york-fs/bms-master/bms_master.kicad_pcb

## KiCad design bms_master.kicad_pcb (2025-06-18)

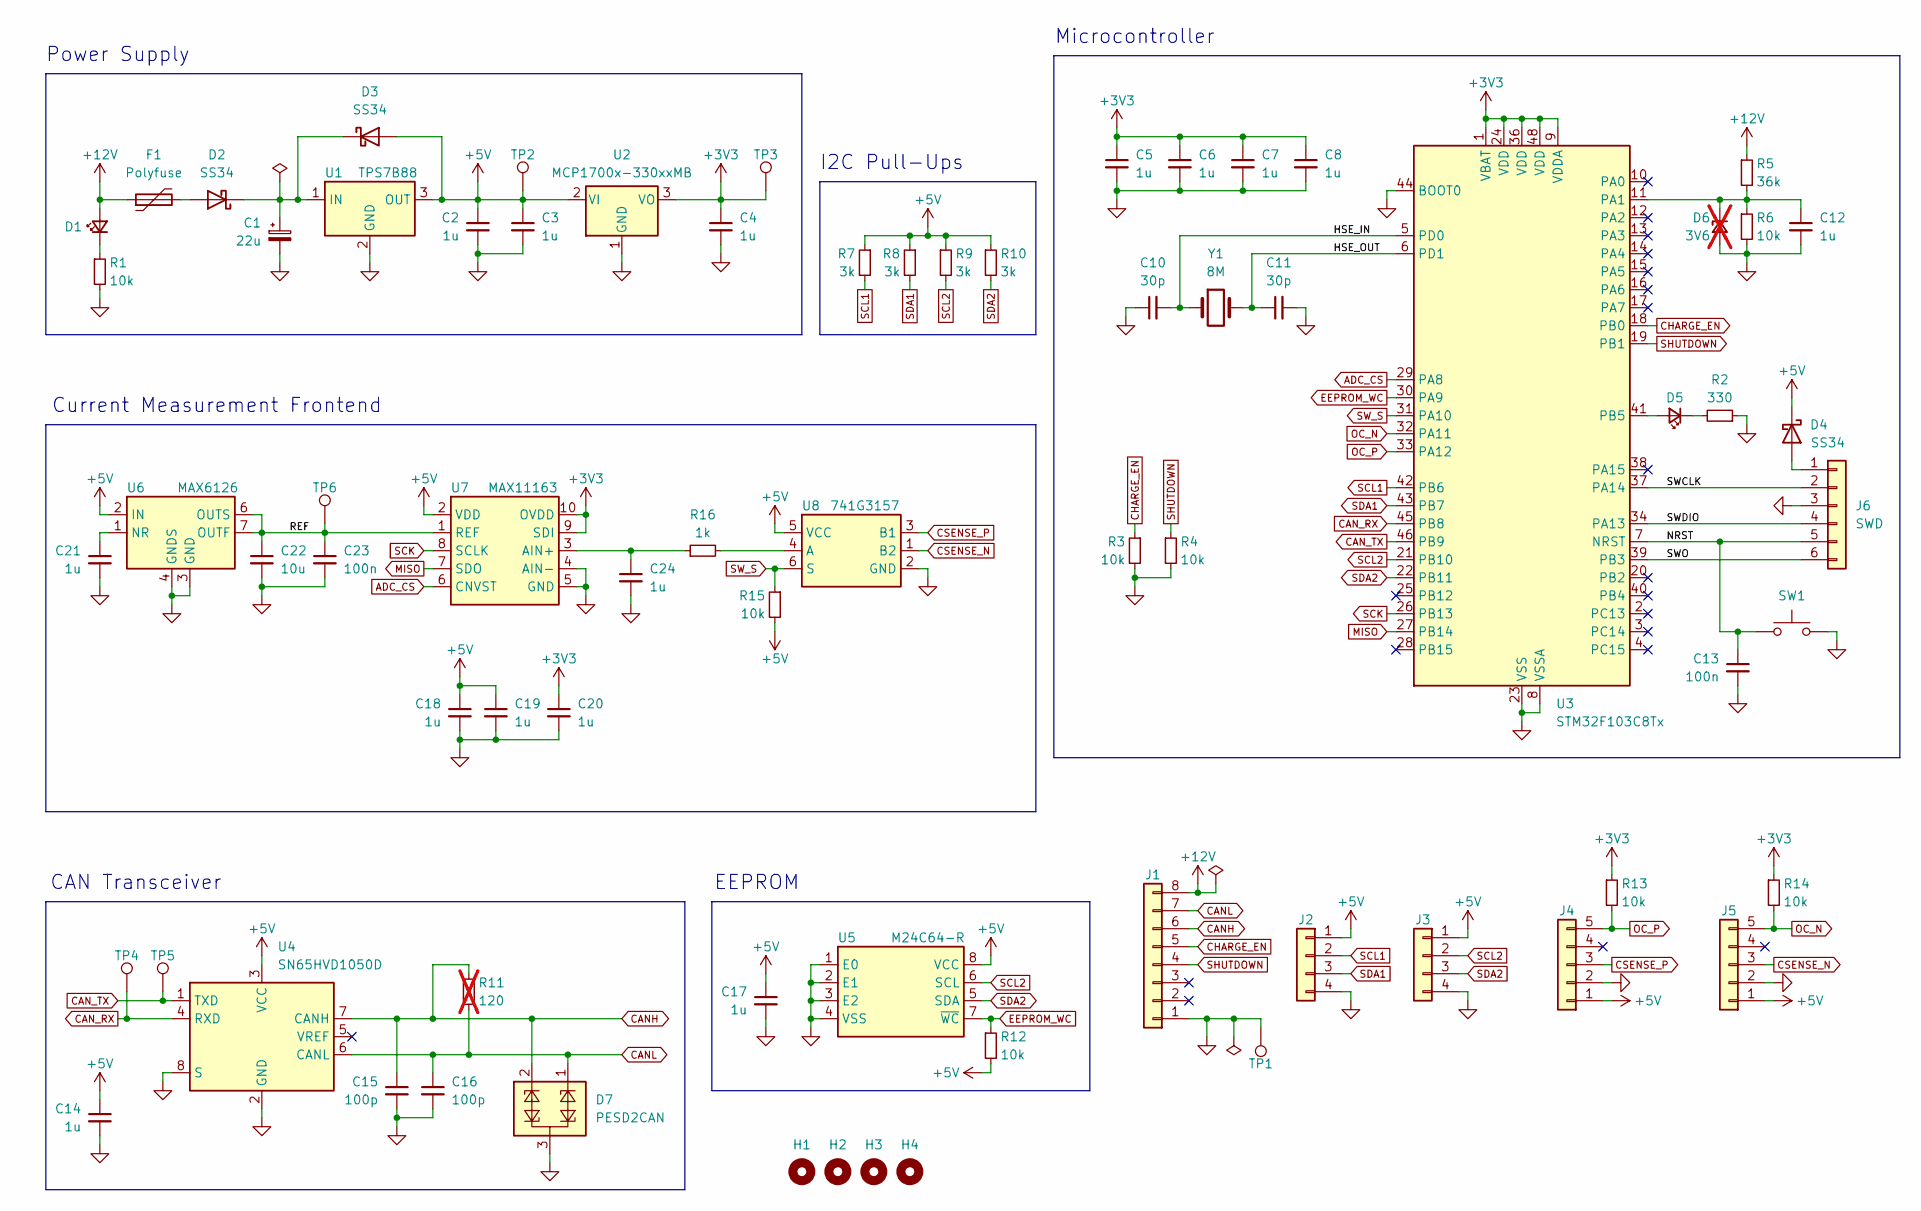
[picture p1: schematic bms_master.kicad_sch, Battery Management System Master]

Parts:
C1: 22u; CP_Elec_6.3x7.7; Mfr # EEEFK1J220XP
C2, C3, C4, C5, C6, C7, C8, C12, C14, C17, C18, C19, C20, C21, C24: 1u; C_0603_1608Metric; Mfr # CL10B105KB8NQNC
C10, C11: 30p; C_0603_1608Metric; Mfr # GQM1875C2E300GB12D
C13, C23: 100n; C_0603_1608Metric; Mfr # CL10B104KB8NNNC
C15, C16: 100p; C_0603_1608Metric
C22: 10u; C_1206_3216Metric; Mfr # GRM31CR71C106KA12L
D1, D5: LED_Small; LED_0603_1608Metric; Mfr # NCD0603R1
D2, D3, D4: SS34; D_SMA; Mfr # SS34-MS
D6: 3V6; D_SOD-323; not fitted
D7: PESD2CAN; SOT-23; Mfr # PESD2CAN,215
F1: Polyfuse; C_0805_2012Metric; Mfr # 0805L010/24YR
H1, H2, H3, H4: MountingHole; MountingHole_3.2mm_M3
J1: Conn_01x08; Molex_Micro-Fit_3.0_43045-0812_2x04_P3.00mm_Vertical
J2, J3: I2C; JST_PH_S4B-PH-K_1x04_P2.00mm_Horizontal; Mfr # S4B-PH-K-S(LF)(SN)
J4, J5: CSENSE; JST_PH_S5B-PH-K_1x05_P2.00mm_Horizontal; Mfr # S5B-PH-K-S(LF)(SN)
J6: SWD; PinHeader_1x06_P2.54mm_Vertical; Mfr # HB-PH3-25417PB2GOP
R1, R3, R4, R6, R12, R13, R14, R15: 10k; R_0603_1608Metric; Mfr # 0603WAF1002T5E
R2: 330; R_0603_1608Metric; Mfr # 0603WAF3300T5E
R5: 36k; R_0603_1608Metric
R7, R8, R9, R10: 3k; R_0603_1608Metric; Mfr # 0603WAF3001T5E
R11: 120; R_0603_1608Metric; not fitted
R16: 1k; R_0603_1608Metric; Mfr # 0603WAF1001T5E
SW1: SW_Push; SW_Push_SPST_NO_Alps_SKRK; Mfr # TS-1088-AR02016
TP1, TP2, TP3, TP4, TP5, TP6: TestPoint; TestPoint_Keystone_5000-5004_Miniature
U1: TPS7B88; TO-252-2; Mfr # 595-TPS7B8850QKVURQ1
U2: MCP1700x-330xxMB; SOT-89-3; Mfr # MCP1700T-3302E/MB
U3: STM32F103C8Tx; LQFP-48_7x7mm_P0.5mm; Mfr # STM32F103C8T6
U4: SN65HVD1050D; SOIC-8_3.9x4.9mm_P1.27mm; Mfr # SN65HVD1050DR
U5: M24C64-R; SOIC-8_3.9x4.9mm_P1.27mm; Mfr # M24C64-RMN6TP
U6: MAX6126; SOIC-8_3.9x4.9mm_P1.27mm; Mfr # MAX6126BASA41+
U7: MAX11163; MSOP-10_3x3mm_P0.5mm; Mfr # MAX11163EUB+
U8: 741G3157; SOT-363_SC-70-6; Mfr # SN74LVC1G3157DCKR
Y1: 8M; Crystal_SMD_5032-2Pin_5.0x3.2mm; Mfr # X50328MSB2GI

Connections:
+3V3: C4.1, C5.1, C6.1, C7.1, C8.1, C20.1, R13.1, R14.1, TP3.1, U2.3 (VO), U3.1 (VBAT), U3.9 (VDDA), U3.24 (VDD), U3.36 (VDD), U3.48 (VDD), U7.9 (SDI), U7.10 (OVDD)
+5V: C2.1, C3.1, C14.1, C17.1, C18.1, C19.1, D3.2 (A), D4.1 (K), J2.1, J3.1, J4.1, J5.1, R7.1, R8.1, R9.1, R10.1, R12.2, R15.2, TP2.1, U1.3 (OUT), U2.2 (VI), U4.3 (VCC), U5.8 (VCC), U6.2 (IN), U7.2 (VDD), U8.5 (VCC)
+12V: D1.2 (A), F1.1, J1.8, R5.1
/HSE_IN: C10.2, U3.5 (PD0), Y1.1
/HSE_OUT: C11.1, U3.6 (PD1), Y1.2
/NRST: C13.1, J6.5, SW1.1, U3.7 (NRST)
/REF: C22.1, C23.1, TP6.1, U6.6 (OUTS), U6.7 (OUTF), U7.1 (REF)
/SWCLK: J6.2, U3.37 (PA14)
/SWDIO: J6.4, U3.34 (PA13)
/SWO: J6.6, U3.39 (PB3)
ADC_CS: U3.29 (PA8), U7.6 (CNVST)
CANH: C15.1, D7.2 (C2), J1.6, R11.1, U4.7 (CANH)
CANL: C16.1, D7.1 (C1), J1.7, R11.2, U4.6 (CANL)
CAN_RX: TP4.1, U3.45 (PB8), U4.4 (RXD)
CAN_TX: TP5.1, U3.46 (PB9), U4.1 (TXD)
CHARGE_EN: J1.5, R3.1, U3.18 (PB0)
CSENSE_N: J5.3, U8.1 (B2)
CSENSE_P: J4.3, U8.3 (B1)
EEPROM_WC: R12.1, U3.30 (PA9), U5.7 (~WC)
GND: C1.2, C2.2, C3.2, C4.2, C5.2, C6.2, C7.2, C8.2, C10.1, C11.2, C12.2, C13.2, C14.2, C15.2, C16.2, C17.2, C18.2, C19.2, C20.2, C21.2, C22.2, C23.2, C24.2, D6.2 (A), D7.3 (CC), J1.1, J2.4, J3.4, J4.2, J5.2, J6.3, R1.2, R2.1, R3.2, R4.2, R6.2, SW1.2, TP1.1, U1.2 (GND), U2.1 (GND), U3.8 (VSSA), U3.23 (VSS), U3.35 (VSS), U3.44 (BOOT0), U3.47 (VSS), U4.2 (GND), U4.8 (S), U5.1 (E0), U5.2 (E1), U5.3 (E2), U5.4 (VSS), U6.3 (GND), U6.4 (GNDS), U7.4 (AIN-), U7.5 (GND), U8.2 (GND)
MISO: U3.27 (PB14), U7.7 (SDO)
unnamed: D1.1 (K), R1.1
unnamed: D2.2 (A), F1.2
unnamed: C1.1, D2.1 (K), D3.1 (K), U1.1 (IN)
unnamed: D4.2 (A), J6.1
unnamed: D5.2 (A), U3.41 (PB5)
unnamed: D5.1 (K), R2.2
unnamed: C12.1, D6.1 (K), R5.2, R6.1, U3.11 (PA1)
unnamed: C21.1, U6.1 (NR)
unnamed: C24.1, R16.1, U7.3 (AIN+)
unnamed: R16.2, U8.4 (A)
OC_N: J5.5, R14.2, U3.32 (PA11)
OC_P: J4.5, R13.2, U3.33 (PA12)
SCK: U3.26 (PB13), U7.8 (SCLK)
SCL1: J2.2, R7.2, U3.42 (PB6)
SCL2: J3.2, R9.2, U3.21 (PB10), U5.6 (SCL)
SDA1: J2.3, R8.2, U3.43 (PB7)
SDA2: J3.3, R10.2, U3.22 (PB11), U5.5 (SDA)
SHUTDOWN: J1.4, R4.1, U3.19 (PB1)
SW_S: R15.1, U3.31 (PA10), U8.6 (S)

Notes on the sheet:
Power Supply
I2C Pull-Ups
Microcontroller
EEPROM
CAN Transceiver
Current Measurement Frontend

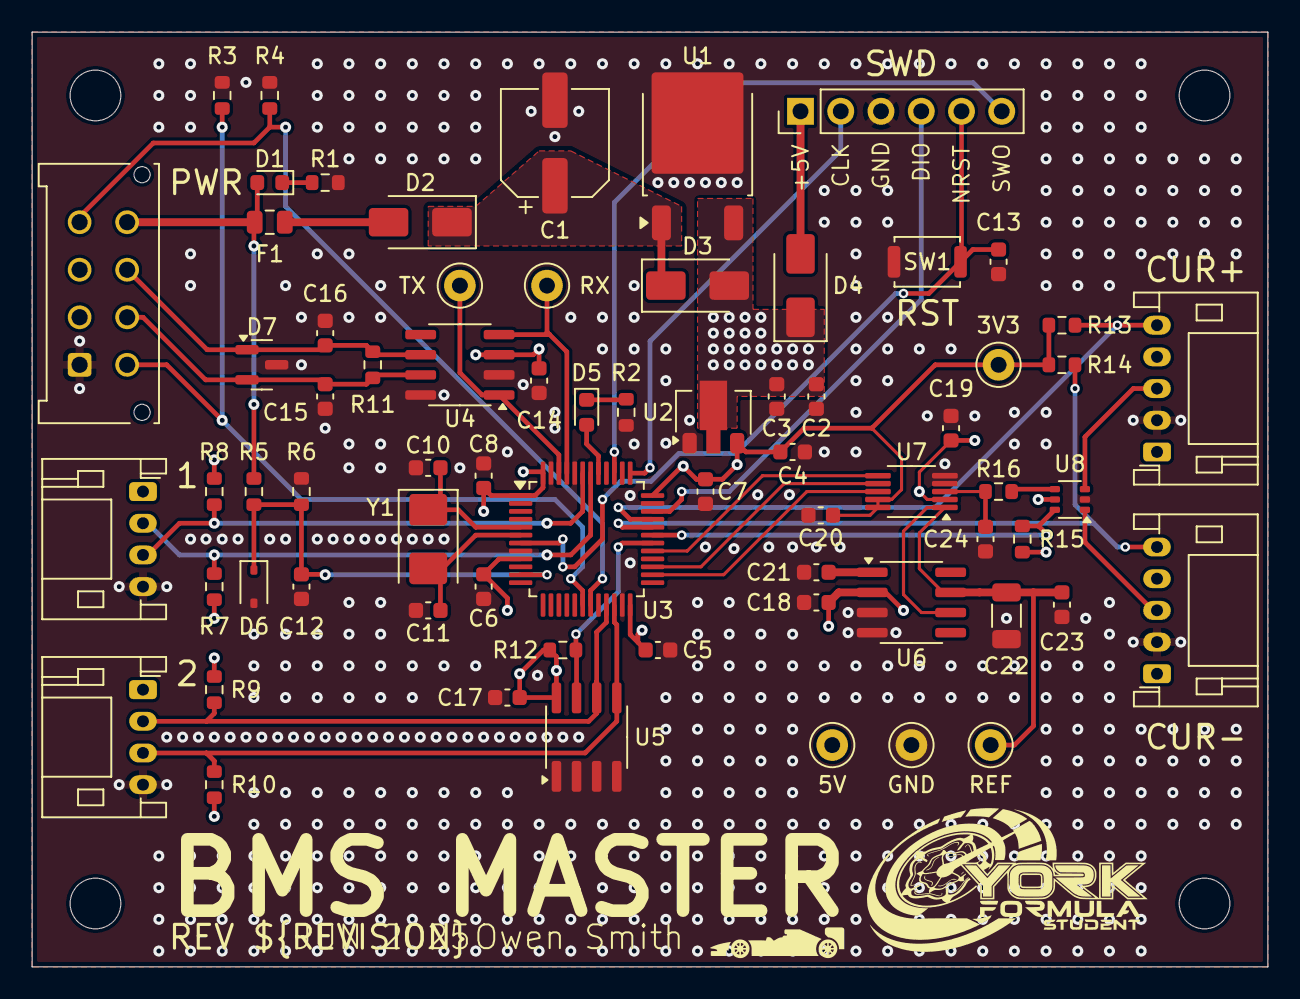
[picture p2: board bms_master.kicad_pcb from above]

Board: 4 copper layers, 78.0 x 59.0 mm, 73 parts (0 on the bottom side), 40 nets.
