york-fs/bms-master/(commit log)

2025-04-27 schematic: Add shutdown and charge enable outputs
    [bms_master.kicad_sch]
2025-04-27 schematic: Measure 12V rail with STM ADC
    [bms_master.kicad_sch]
2025-04-27 schematic: Re-annotate designators
    [bms_master.kicad_sch]
2025-04-27 schematic: Fix overcurrent pin pull-up voltage
    [bms_master.kicad_sch]
2025-04-27 schematic: Assign some net classes
2025-05-04 schematic: Assign most footprints
    [bms_master.kicad_sch]
2025-05-04 schematic: Fill in most BOM info
    [bms_master.kicad_sch]
2025-05-04 schematic: Allow powering 5V rail from SWD header
    [bms_master.kicad_sch]
2025-05-04 schematic: Choose a footprint for the main connector
    [bms_master.kicad_sch]
2025-05-04 pcb: Setup PCB settings
    [bms_master.kicad_pcb]
2025-05-04 *: Add initial PCB layout
    [bms_master.kicad_pcb, bms_master.kicad_sch]
2025-05-04 pcb: Move connectors slightly towards board edge
    [bms_master.kicad_pcb]
2025-05-04 pcb: Add some more silkscreen
    [bms_master.kicad_pcb]
2025-05-05 pcb: Improve silkscreen and add a few more GND vias
    [bms_master.kicad_pcb]
2025-05-05 *: Bump issue date
    [bms_master.kicad_pcb, bms_master.kicad_sch]
2025-05-05 pcb: Run cleanup graphics
    [bms_master.kicad_pcb]
2025-05-05 pcb: Run cleanup tracks
    [bms_master.kicad_pcb]
2025-05-05 pcb: Move OC_N track slightly
    [bms_master.kicad_pcb]
2025-05-11 pcb: Add some more GND vias
    [bms_master.kicad_pcb]
2025-05-11 pcb: Add GND between SPI lines
    [bms_master.kicad_pcb]
2025-05-11 pcb: Set gerber output parameters
    [bms_master.kicad_pcb]
2025-06-04 *: Update library references and move SWD header slightly
    [bms_master.kicad_pcb, bms_master.kicad_sch]
2025-06-07 *: Change all 100k pull-up and pull-downs to 10k
    [bms_master.kicad_pcb, bms_master.kicad_sch]
2025-06-07 pcb: Remove unnecessary 5V via for test point
    [bms_master.kicad_pcb]
2025-06-07 *: Add a test point for the reference
    [bms_master.kicad_pcb, bms_master.kicad_sch]
2025-06-18 *: Mirror I2C connector pin order
    [bms_master.kicad_pcb, bms_master.kicad_sch]
2025-06-18 pcb: Update even more library references
    [bms_master.kicad_pcb]
2025-06-18 pcb: Remove some 5V vias
    [bms_master.kicad_pcb]
2025-06-18 pcb: Enable PTH thermal reliefs for 5V and GND planes
    [bms_master.kicad_pcb]
2025-06-18 pcb: Improve silkscreen
    [bms_master.kicad_pcb]
2025-06-18 *: Bump to revision B
    [bms_master.kicad_pcb, bms_master.kicad_sch]
